vmshade/Pinecone/Pinecone V1/production/bom.csv

Part Number | LCSC Part | Designators | Qty | Source | Extended Price (USD) | JLCPCB Library Type | Manufacturer | Description
RC0402FR-07680KL | C163456 | R10 | 20 | JLCPCB | 0.08 | Extended | YAGEO | Resistor 680 kΩ, 0402
FRC0402F27R0TS | C2909343 | R3,R4 | 20 | JLCPCB | 0.036 | Extended | FOJAN | Resistor 27 Ω, 0402
USBLC6-2SC6 | C2827654 | U4 | 9 | JLCPCB | 0.4023 | Extended | TECH PUBLIC | USB ESD protection
CL05A105KA5NQNC | C52923 | C1,C10 | 10 | JLCPCB | 0.087 | Basic | Samsung Electro-Mechanics | Capacitor 1 µF, 0402
KT-0805G | C2297 | D3 | 5 | JLCPCB | 0.0815 | Basic | Hubei KENTO | Green LED, 0805
0402CG150J500NT | C1548 | C15,C16 | 10 | JLCPCB | 0.038 | Basic | Fenghua | Capacitor 15 pF, 0402
0402WGF1001TCE | C11702 | R5,R6 | 10 | JLCPCB | 0.035 | Basic | UNI-ROYAL | Resistor 1 kΩ, 0402
0402WGF5101TCE | C25905 | R1,R2 | 10 | JLCPCB | 0.024 | Basic | UNI-ROYAL | Resistor 5.1 kΩ, 0402
0402WGF1002TCE | C25744 | R7,R8 | 10 | JLCPCB | 0.034 | Basic | UNI-ROYAL | Resistor 10 kΩ, 0402
TLV75533PDRVR | C2861750 | U1 | 5 | JLCPCB | 1.426 | Extended | Texas Instruments | 3.3 V LDO regulator
CL10A106KP8NNNC | C19702 | C13,C14 | 10 | JLCPCB | 0.305 | Basic | Samsung Electro-Mechanics | Capacitor 10 µF, 0603
W25Q128JVPIQ | C190862 | U3 | 5 | JLCPCB | 16.906 | Extended | Winbond | 128 Mbit QSPI flash
RP2040 | C2040 | U5 | 5 | JLCPCB | 4.9515 | Extended | Raspberry Pi | RP2040 microcontroller
CL05B104KO5NNNC | C1525 | C11,C12,C17,C2,... | 60 | JLCPCB | 0.27 | Basic | Samsung Electro-Mechanics | Capacitor 100 nF, 0402; designators truncated in source
SMF5V0A-E3-08 | C1972946 | D1 | 7 | JLCPCB | 1.0731 | Extended | Vishay | 5 V TVS diode
1206L075/24NR | C7542952 | F1 | 9 | JLCPCB | 0.4581 | Extended | LUTE | Resettable fuse / polyfuse, 1206
TAXM12M4RLBDDT2T | C133334 | Y1 | 9 | JLCPCB | 0.711 | Extended | Yajingxin | 12 MHz crystal
TYPE-C-31-M-12 | C165948 | J2 | 5 | JLCPCB | 0.93 | Extended | Korean Hroparts | USB Type-C connector
