vmshade/Pinecone/Pinecone V1/Pinecone V1.kicad_pcb

## KiCad design Pinecone V1/Pinecone V1.kicad_pcb (2026-10-11)

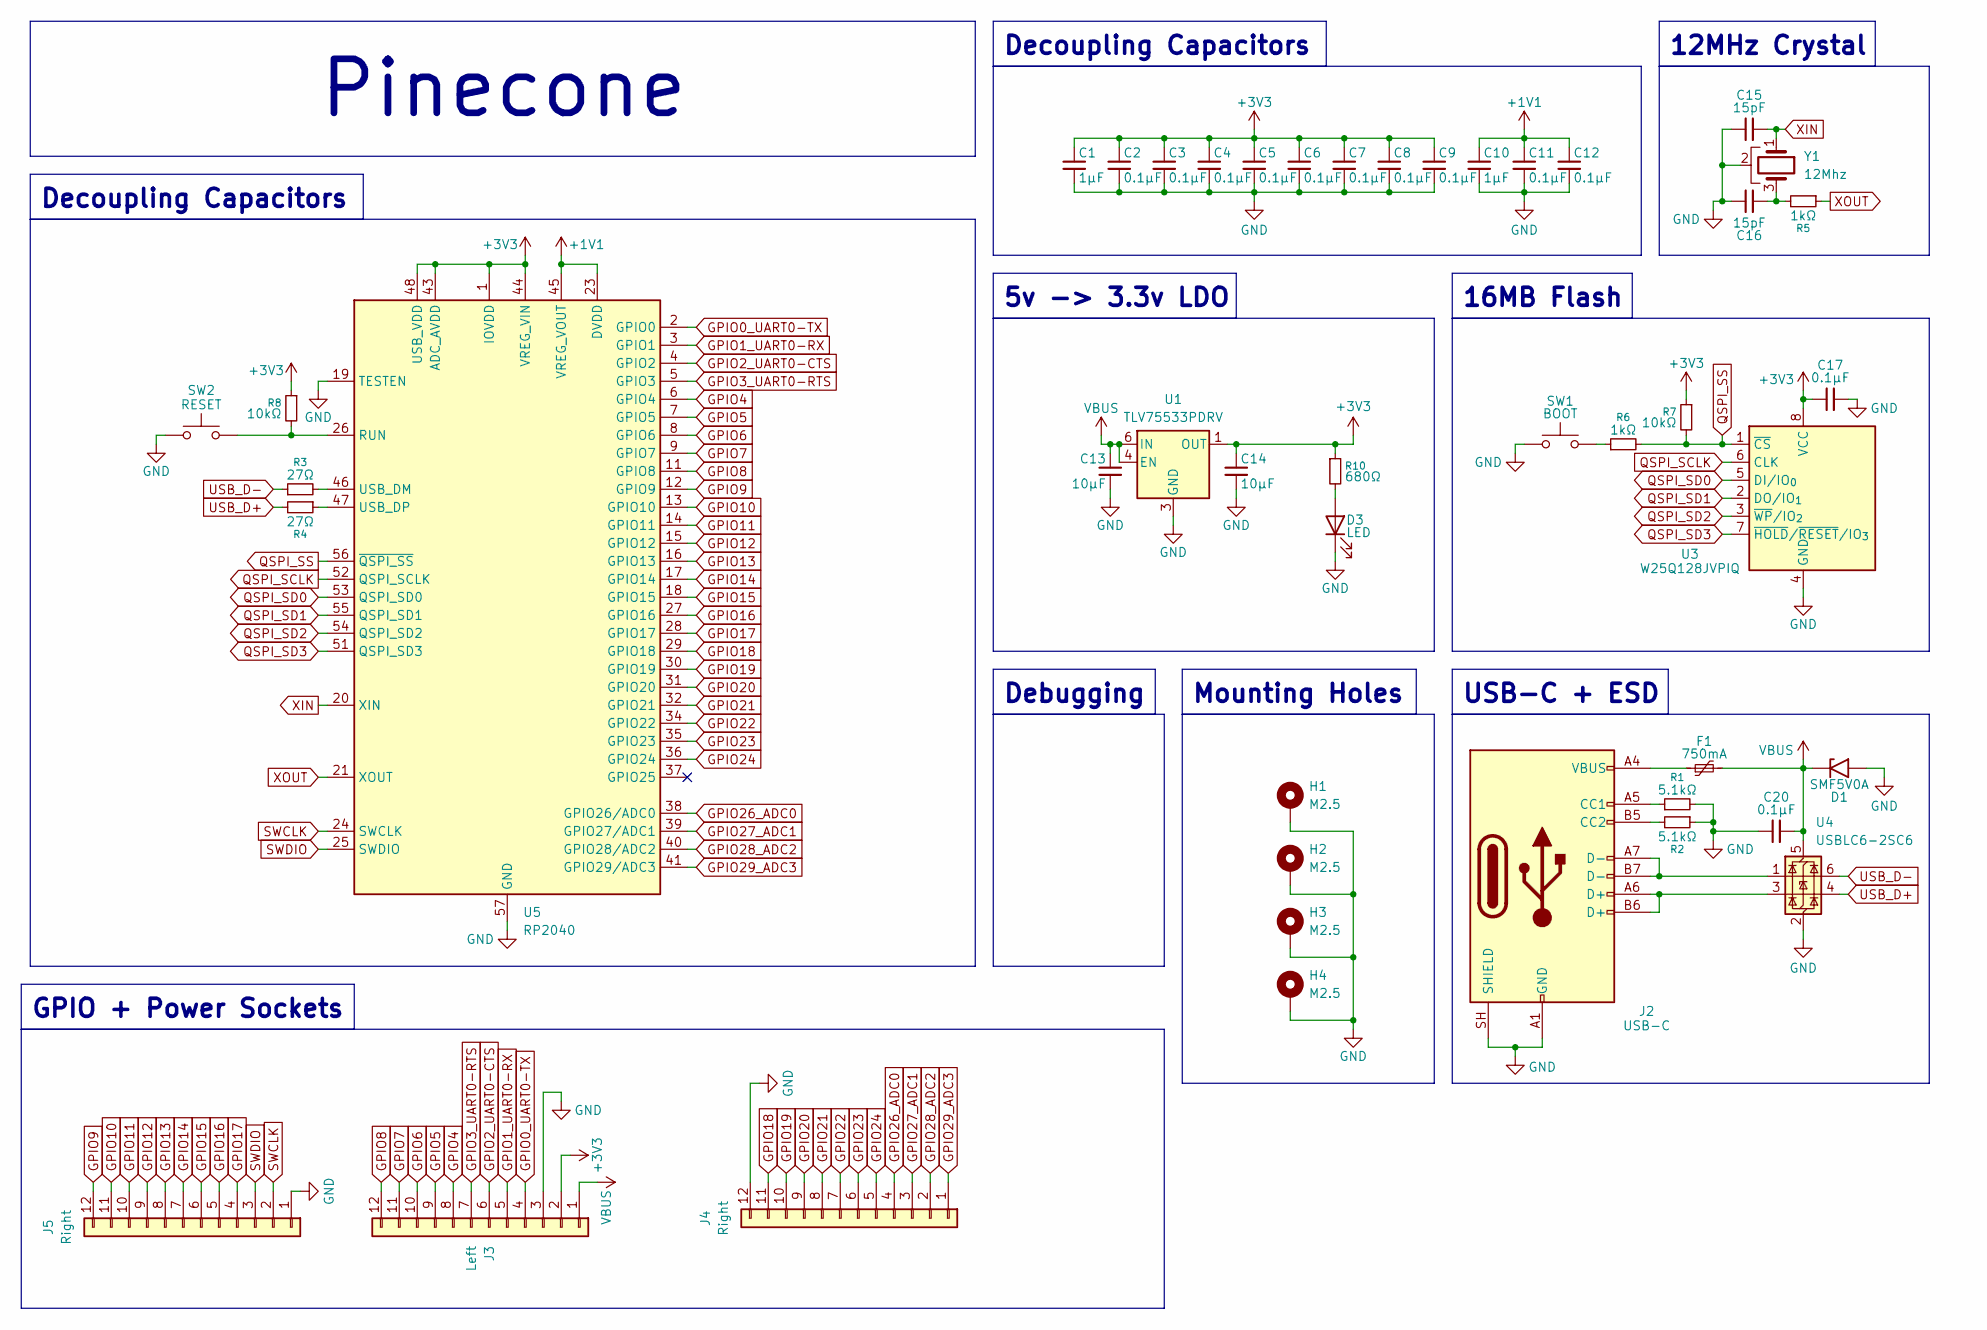
[picture p1: schematic Pinecone V1.kicad_sch, Pinecone]

Parts:
C1, C10: 1µF; C_0402_1005Metric
C2, C3, C4, C5, C6, C7, C8, C9, C11, C12, C17, C20: 0.1µF; C_0402_1005Metric
C13, C14: 10µF; C_0603_1608Metric
C15, C16: 15pF; C_0402_1005Metric
D1: SMF5V0A; D_SMF
D3: LED; LED_0805_2012Metric
F1: 750mA; Fuse_1206_3216Metric
H1, H2, H3, H4: M2.5; MountingHole_2.7mm_M2.5_Pad
J2: USB-C; USB_C_Receptacle_HRO_TYPE-C-31-M-12
J3: Left; PinSocket_1x12_P2.54mm_Vertical
J4, J5: Right; PinSocket_1x12_P2.54mm_Vertical_F
R1, R2: 5.1kΩ; R_0402_1005Metric
R3, R4: 27Ω; R_0402_1005Metric
R5, R6: 1kΩ; R_0402_1005Metric
R7, R8: 10kΩ; R_0402_1005Metric
R10: 680Ω; R_0402_1005Metric
SW1: BOOT; SW_PUSH_6mm
SW2: RESET; SW_PUSH_6mm
U1: TLV75533PDRV; WSON-6-1EP_2x2mm_P0.65mm_EP1x1.6mm
U3: W25Q128JVPIQ; WSON-8-1EP_6x5mm_P1.27mm_EP3.4x4.3mm
U4: USBLC6-2SC6; SOT-23-6
U5: RP2040; QFN-56-1EP_7x7mm_P0.4mm_EP3.2x3.2mm
Y1: 12Mhz; Crystal_SMD_3225-4Pin_3.2x2.5mm

Connections:
+1V1: C10.1, C11.1, C12.1, U5.23 (DVDD), U5.45 (VREG_VOUT), U5.50 (DVDD)
+3V3: C1.1, C2.1, C3.1, C4.1, C5.1, C6.1, C7.1, C8.1, C9.1, C14.1, C17.1, J3.2, R7.1, R8.1, R10.1, U1.1 (OUT), U3.8 (VCC), U5.1 (IOVDD), U5.10 (IOVDD), U5.22 (IOVDD), U5.33 (IOVDD), U5.42 (IOVDD), U5.43 (ADC_AVDD), U5.44 (VREG_VIN), U5.48 (USB_VDD), U5.49 (IOVDD)
GND: C1.2, C2.2, C3.2, C4.2, C5.2, C6.2, C7.2, C8.2, C9.2, C10.2, C11.2, C12.2, C13.2, C14.2, C15.1, C16.2, C17.2, C20.1, D1.2 (A2), D3.1 (K), H1.1 (1_1), H2.1 (1_1), H3.1 (1_1), H4.1 (1_1), J2.A1 (GND), J2.A12 (GND), J2.B1 (GND), J2.B12 (GND), J2.SH (SHIELD), J3.3, J4.12, J5.1, R1.2, R2.1, SW1.1, SW2.1, U1.3 (GND), U1.7 (GND), U3.4 (GND), U4.2 (GND), U5.19 (TESTEN), U5.57 (GND), Y1.2; also elsewhere on the board
GPIO0_UART0-TX: J3.4, U5.2 (GPIO0)
GPIO1_UART0-RX: J3.5, U5.3 (GPIO1)
GPIO2_UART0-CTS: J3.6, U5.4 (GPIO2)
GPIO3_UART0-RTS: J3.7, U5.5 (GPIO3)
GPIO4: J3.8, U5.6 (GPIO4)
GPIO5: J3.9, U5.7 (GPIO5)
GPIO6: J3.10, U5.8 (GPIO6)
GPIO7: J3.11, U5.9 (GPIO7)
GPIO8: J3.12, U5.11 (GPIO8)
GPIO9: J5.12, U5.12 (GPIO9)
GPIO10: J5.11, U5.13 (GPIO10)
GPIO11: J5.10, U5.14 (GPIO11)
GPIO12: J5.9, U5.15 (GPIO12)
GPIO13: J5.8, U5.16 (GPIO13)
GPIO14: J5.7, U5.17 (GPIO14)
GPIO15: J5.6, U5.18 (GPIO15)
GPIO16: J5.5, U5.27 (GPIO16)
GPIO17: J5.4, U5.28 (GPIO17)
GPIO18: J4.11, U5.29 (GPIO18)
GPIO19: J4.10, U5.30 (GPIO19)
GPIO20: J4.9, U5.31 (GPIO20)
GPIO21: J4.8, U5.32 (GPIO21)
GPIO22: J4.7, U5.34 (GPIO22)
GPIO23: J4.6, U5.35 (GPIO23)
GPIO24: J4.5, U5.36 (GPIO24)
GPIO26_ADC0: J4.4, U5.38 (GPIO26/ADC0)
GPIO27_ADC1: J4.3, U5.39 (GPIO27/ADC1)
GPIO28_ADC2: J4.2, U5.40 (GPIO28/ADC2)
GPIO29_ADC3: J4.1, U5.41 (GPIO29/ADC3)
NeoPixel: U5.37 (GPIO25)
unnamed: C16.1, R5.2, Y1.3
unnamed: D3.2 (A), R10.2
unnamed: F1.1, J2.A4 (VBUS), J2.A9 (VBUS), J2.B4 (VBUS), J2.B9 (VBUS)
unnamed: J2.A5 (CC1), R1.1
unnamed: J2.B5 (CC2), R2.2
unnamed: J2.A6 (D+), J2.B6 (D+), U4.3 (I/O2)
unnamed: J2.A7 (D-), J2.B7 (D-), U4.1 (I/O1)
unnamed 40: R6.1, SW1.2; also elsewhere on the board
unnamed 41: R8.2, SW2.2, U5.26 (RUN); also elsewhere on the board
unnamed: R3.2, U5.46 (USB_DM)
unnamed: R4.1, U5.47 (USB_DP)
QSPI_SCLK: U3.6 (CLK), U5.52 (QSPI_SCLK)
QSPI_SD0: U3.5 (DI/IO_{0}), U5.53 (QSPI_SD0)
QSPI_SD1: U3.2 (DO/IO_{1}), U5.55 (QSPI_SD1)
QSPI_SD2: U3.3 (~WP/IO_{2}), U5.54 (QSPI_SD2)
QSPI_SD3: U3.7 (~HOLD/~RESET/IO_{3}), U5.51 (QSPI_SD3)
QSPI_SS: R6.2, R7.2, U3.1 (~CS), U5.56 (~QSPI_SS)
SWCLK: J5.2, U5.24 (SWCLK)
SWDIO: J5.3, U5.25 (SWDIO)
USB_D+: R4.2, U4.4 (I/O2)
USB_D-: R3.1, U4.6 (I/O1)
VBUS: C13.1, C20.2, D1.1 (A1), F1.2, J3.1, U1.4 (EN), U1.6 (IN), U4.5 (VBUS)
XIN: C15.2, U5.20 (XIN), Y1.1
XOUT: R5.1, U5.21 (XOUT)

Notes on the sheet:
12MHz Crystal
5v -> 3.3v LDO
Decoupling Capacitors
Pinecone
Mounting Holes
GPIO + Power Sockets
16MB Flash
USB-C + ESD
Debugging

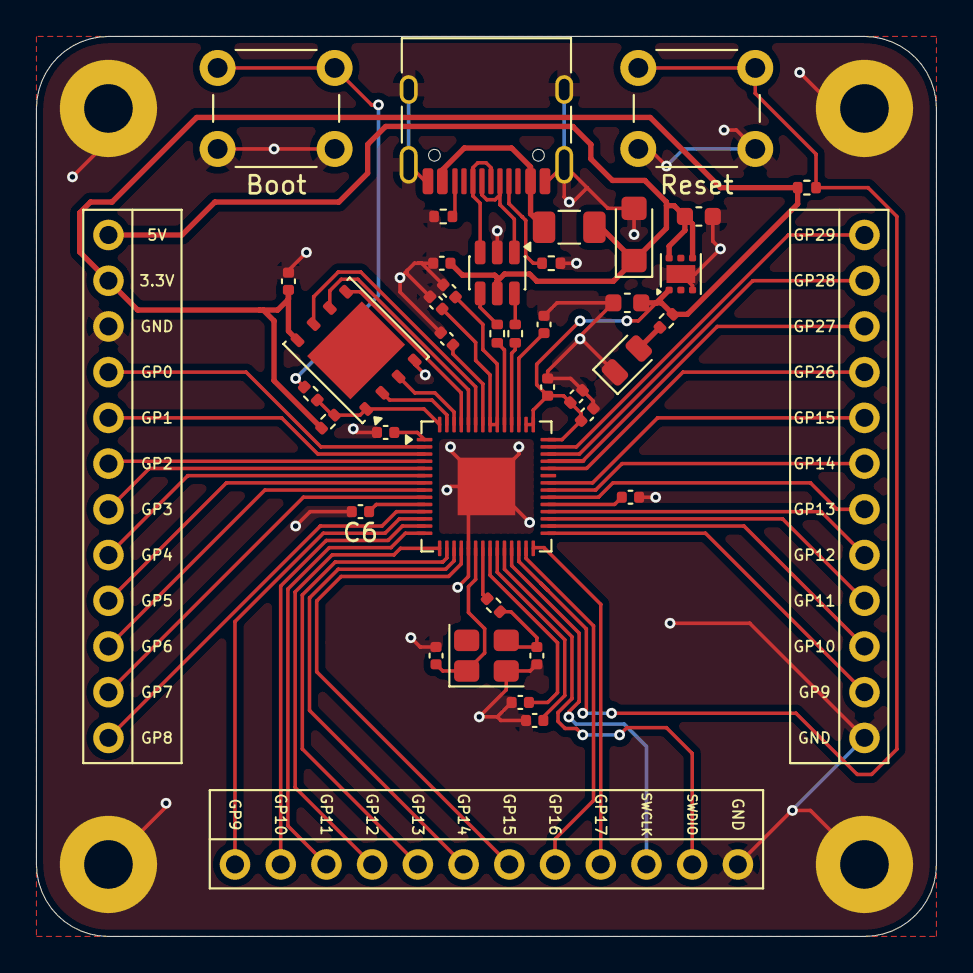
[picture p2: board Pinecone V1.kicad_pcb from above]

Board: 2 copper layers, 50.0 x 50.0 mm, 45 parts (0 on the bottom side), 56 nets.

Other parts of the board:
Boot: BOOT; SW_PUSH_6mm
Reset: RESET; SW_PUSH_6mm

Their connections:
GND: Boot.1, Reset.1; also elsewhere on the board
unnamed 40: Boot.2; also elsewhere on the board
unnamed 41: Reset.2; also elsewhere on the board
