vmshade/Pinecone/(commit log)

2026-10-11 Uploaded final files
    [Pinecone V1.kicad_pcb, Pinecone V1.kicad_sch]
2026-10-11 Add README for Pinecone RP2040 dev board
    Added project description and features for Pinecone dev board.
2026-10-11 Fixed a Resistor Value Typo
    [Pinecone V1.kicad_pcb, Pinecone V1.kicad_sch, bom.csv, designators.csv, positions.csv]
2026-10-11 PCB V2
    [Pinecone V1.kicad_pcb, Pinecone V1.kicad_sch, bom.csv, designators.csv, positions.csv]
2026-10-11 Updated BOM
    [bom.csv, bom.xls]
2026-10-11 Updated BOM (2)
    [bom.csv]
2026-10-11 BOM update
    [bom.csv]
